IgoorCosta/codesDeficientesFisicos/TCC - Peças SolidWorks/Montagem protótipo.SLDASM

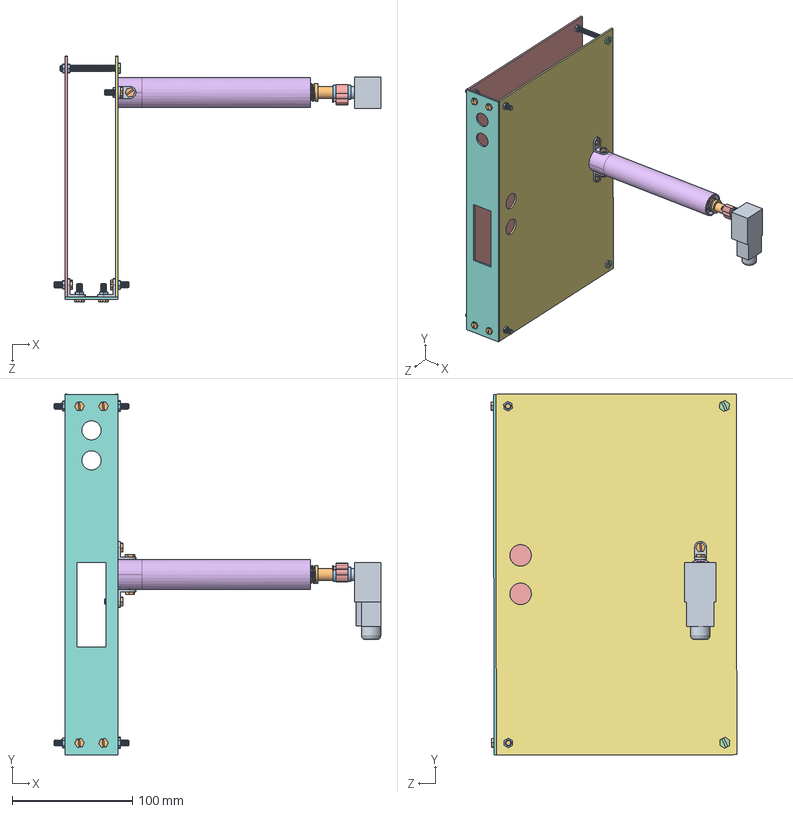
[picture p33: CAD file, 2024-02-06]
TCC - Peças SolidWorks/Montagem protótipo.SLDASM
271.6 x 300.2 x 204.3 mm
Motor
Rosca sem Fim
Mangueira
Porca grande x 4
Abraçadeira
PVC
Bancada inferior
Bancada da frente
Dobradiça x 6
Parafuso pequeno x 12
Porca pequena x 13
Parafuso Grande x 2
Bancada superior
