IgoorCosta/codesDeficientesFisicos/TCC - Peças SolidWorks/Montagem parte superior filme.SLDASM

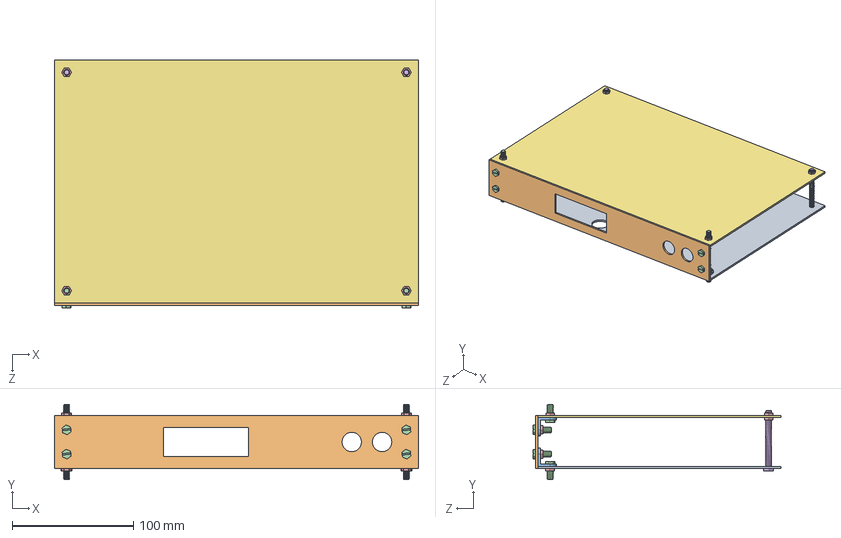
[picture p34: CAD file, 2024-02-06]
TCC - Peças SolidWorks/Montagem parte superior filme.SLDASM
300.0 x 62.0 x 204.0 mm
Bancada inferior
Bancada da frente
Dobradiça x 4
Parafuso pequeno x 8
Porca pequena x 12
Parafuso Grande x 2
Bancada superior
