IgoorCosta/codesDeficientesFisicos/TCC - Peças SolidWorks/Montagem parte inferior2.SLDASM

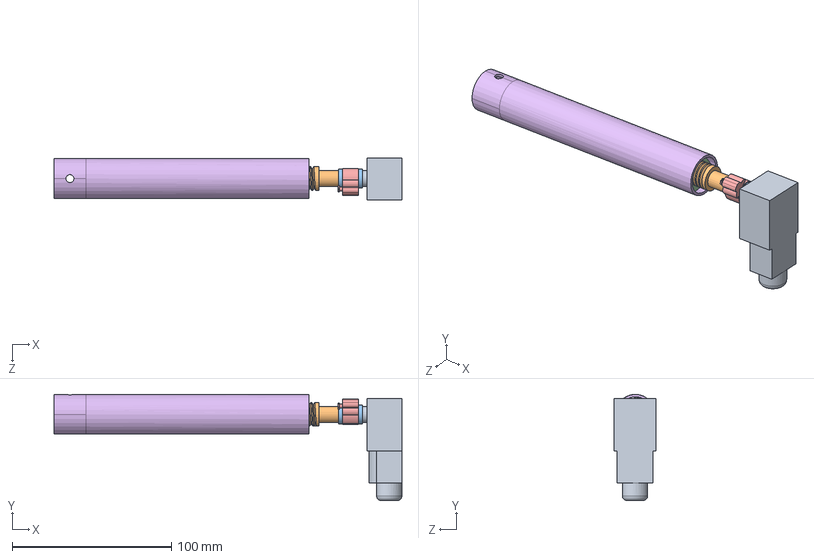
[picture p35: CAD file, 2024-02-06]
TCC - Peças SolidWorks/Montagem parte inferior2.SLDASM
218.6 x 66.7 x 26.5 mm
Motor
Rosca sem Fim
Mangueira
Porca grande x 4
Abraçadeira
PVC
