IgoorCosta/codesDeficientesFisicos/TCC - Peças SolidWorks/Montagem parte inferior.SLDASM

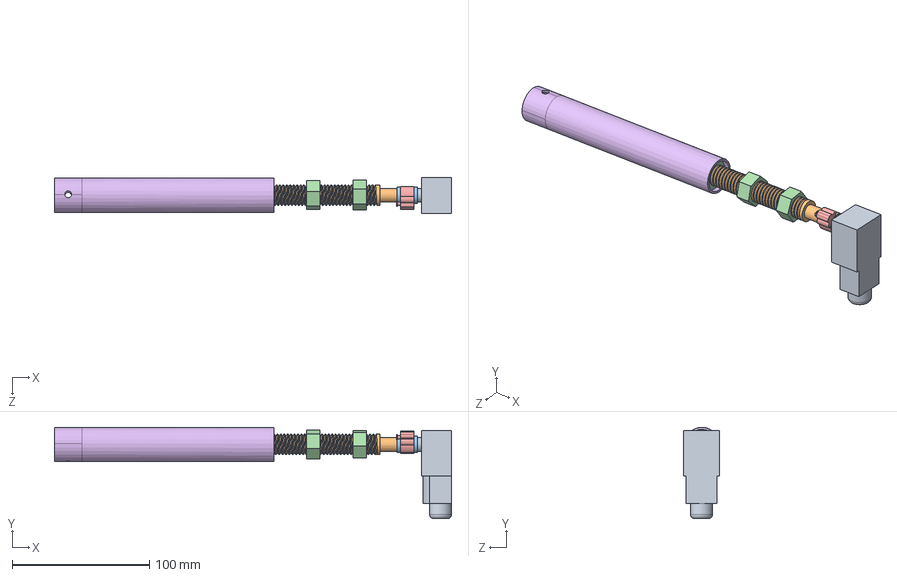
[picture p36: CAD file, 2024-02-06]
TCC - Peças SolidWorks/Montagem parte inferior.SLDASM
289.6 x 66.7 x 26.5 mm
Motor
Rosca sem Fim
Mangueira
Porca grande x 4
Abraçadeira
PVC
