IgoorCosta/codesDeficientesFisicos/TCC - Peças SolidWorks/Dobradiça.SLDPRT

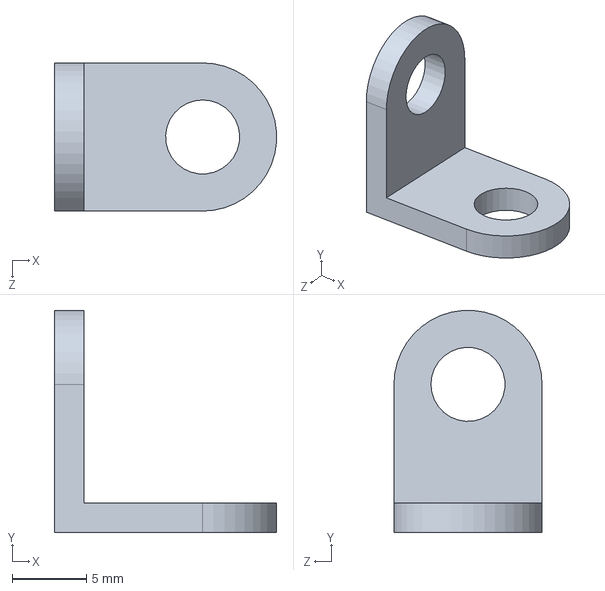
[picture p38: CAD file, 2024-02-06]
TCC - Peças SolidWorks/Dobradiça.SLDPRT
15.0 x 15.0 x 10.0 mm
