IgoorCosta/codesDeficientesFisicos/TCC - Peças SolidWorks/vermelho.SLDPRT

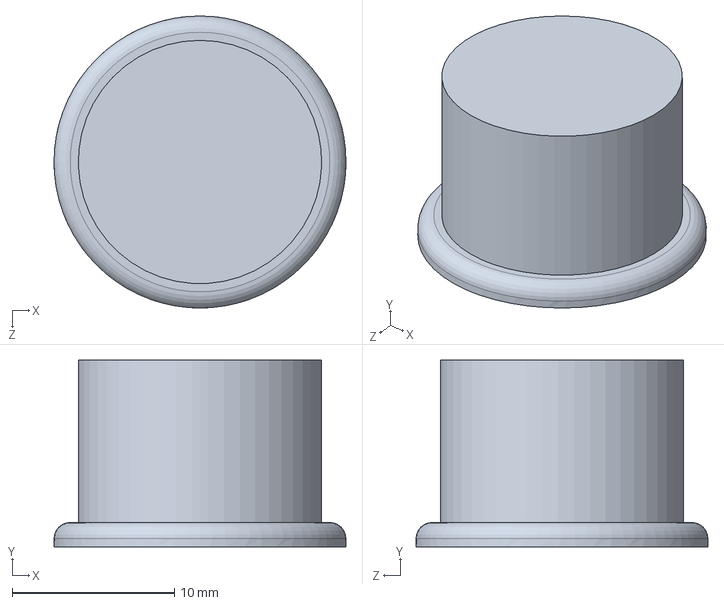
[picture p39: CAD file, 2024-02-06]
TCC - Peças SolidWorks/vermelho.SLDPRT
18.0 x 11.5 x 18.0 mm
