IgoorCosta/codesDeficientesFisicos/TCC - Peças SolidWorks/Abraçadeira.SLDPRT

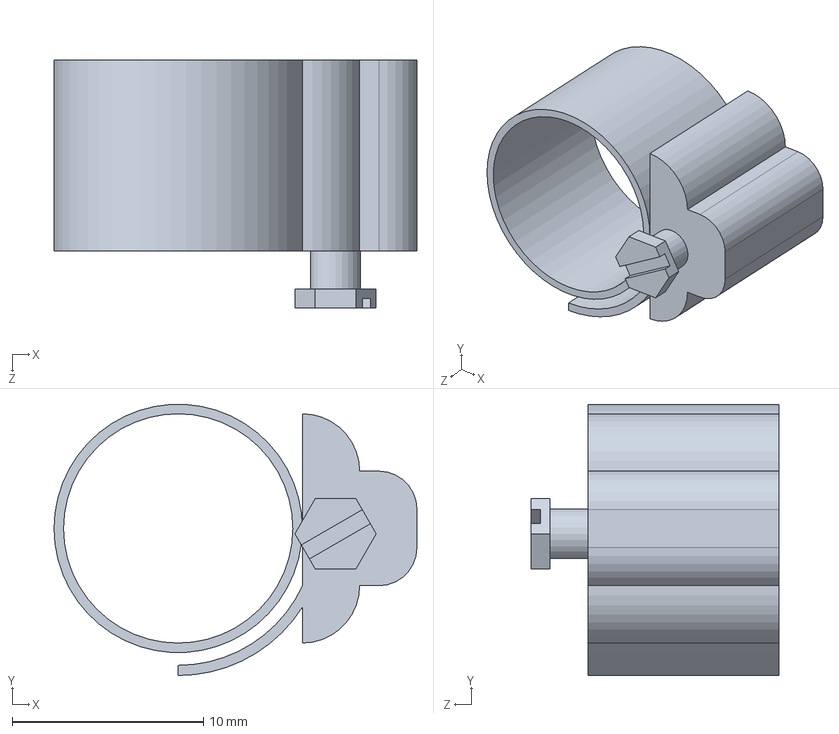
[picture p40: CAD file, 2024-02-06]
TCC - Peças SolidWorks/Abraçadeira.SLDPRT
19.0 x 14.2 x 13.0 mm
