IgoorCosta/codesDeficientesFisicos/TCC - Peças SolidWorks/Motor.SLDPRT

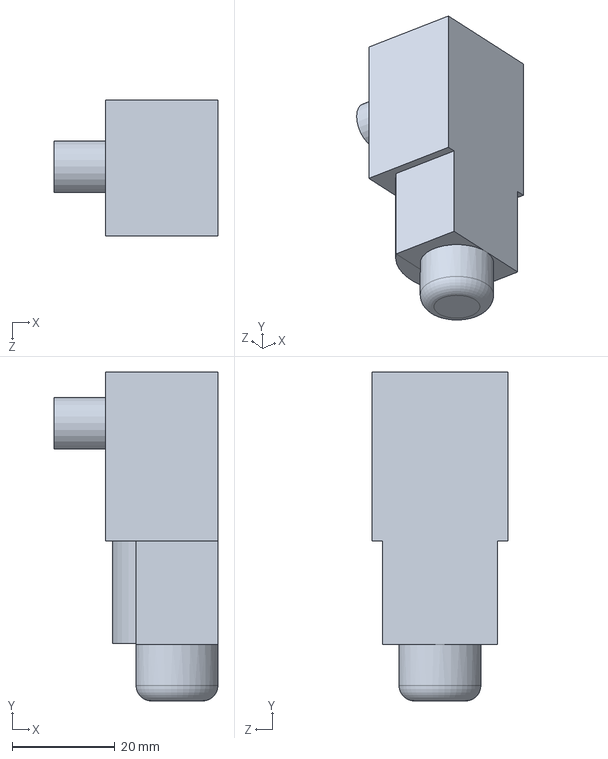
[picture p41: CAD file, 2024-02-06]
TCC - Peças SolidWorks/Motor.SLDPRT
32.0 x 64.2 x 26.5 mm
