IgoorCosta/codesDeficientesFisicos/TCC - Peças SolidWorks/Bancada inferior.SLDPRT

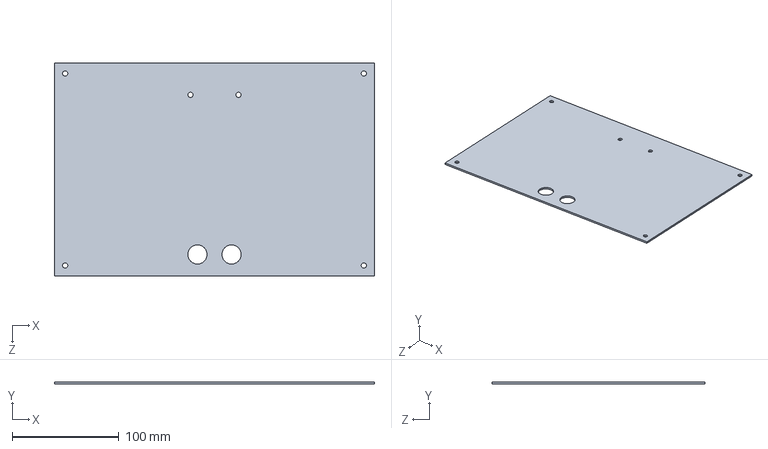
[picture p42: CAD file, 2024-02-06]
TCC - Peças SolidWorks/Bancada inferior.SLDPRT
300.0 x 2.00 x 200.0 mm
