IgoorCosta/codesDeficientesFisicos/TCC - Peças SolidWorks/LCD.SLDPRT

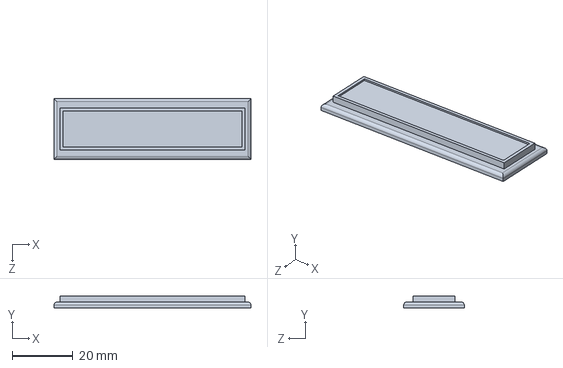
[picture p43: CAD file, 2024-02-06]
TCC - Peças SolidWorks/LCD.SLDPRT
65.0 x 4.00 x 20.0 mm
