IgoorCosta/codesDeficientesFisicos/TCC - Peças SolidWorks/Rosca sem Fim.SLDPRT

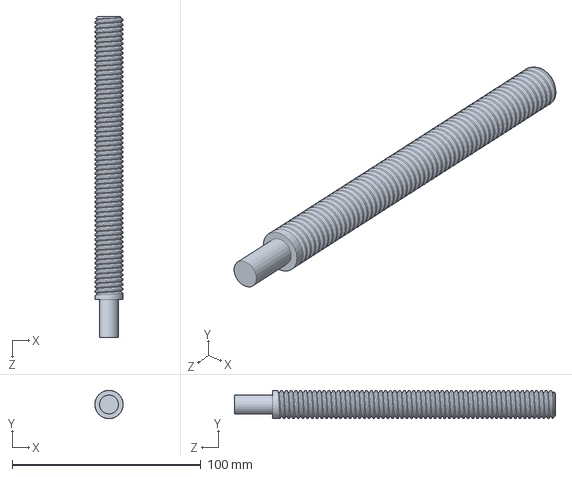
[picture p44: CAD file, 2024-02-06]
TCC - Peças SolidWorks/Rosca sem Fim.SLDPRT
15.0 x 15.0 x 170.0 mm
