IgoorCosta/codesDeficientesFisicos/TCC - Peças SolidWorks/Porca grande.SLDPRT

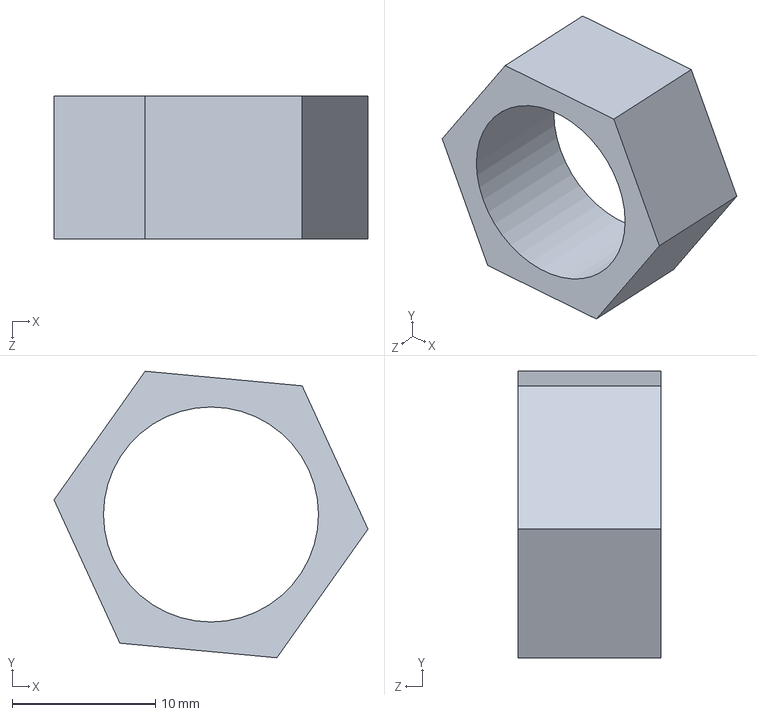
[picture p45: CAD file, 2024-02-06]
TCC - Peças SolidWorks/Porca grande.SLDPRT
21.9 x 20.0 x 10.0 mm
