IgoorCosta/codesDeficientesFisicos/TCC - Peças SolidWorks/Bancada da frente.SLDPRT

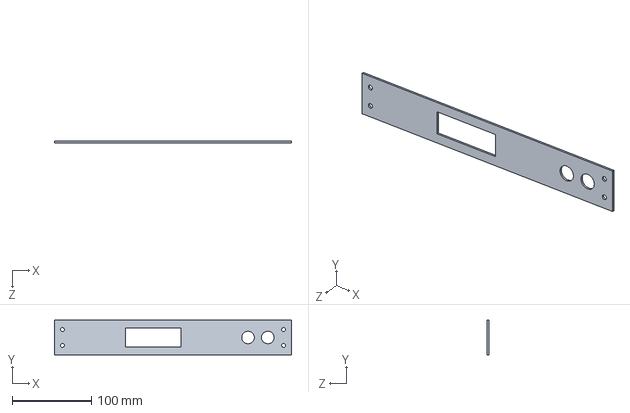
[picture p46: CAD file, 2024-02-06]
TCC - Peças SolidWorks/Bancada da frente.SLDPRT
300.0 x 44.0 x 2.00 mm
