IgoorCosta/codesDeficientesFisicos/TCC - Peças SolidWorks/Mangueira.SLDPRT

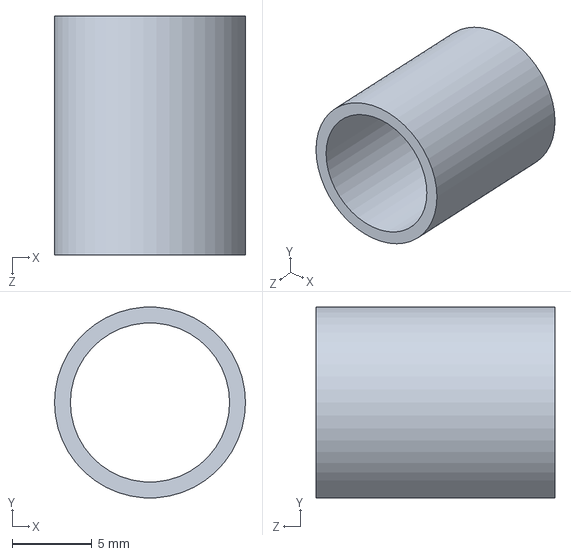
[picture p47: CAD file, 2024-02-06]
TCC - Peças SolidWorks/Mangueira.SLDPRT
12.0 x 12.0 x 15.0 mm
