IgoorCosta/codesDeficientesFisicos/TCC - Peças SolidWorks/PVC.SLDPRT

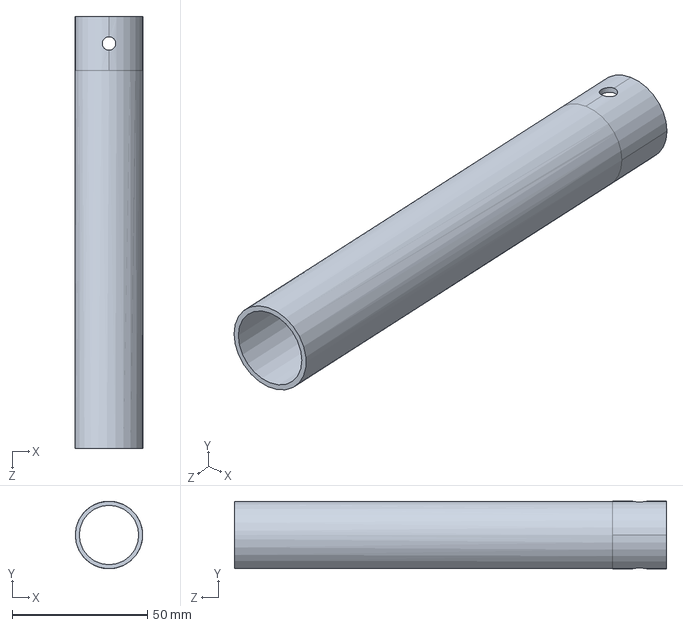
[picture p48: CAD file, 2024-02-06]
TCC - Peças SolidWorks/PVC.SLDPRT
25.0 x 25.0 x 160.0 mm
