IgoorCosta/codesDeficientesFisicos/TCC - Peças SolidWorks/Parafuso Grande.SLDPRT

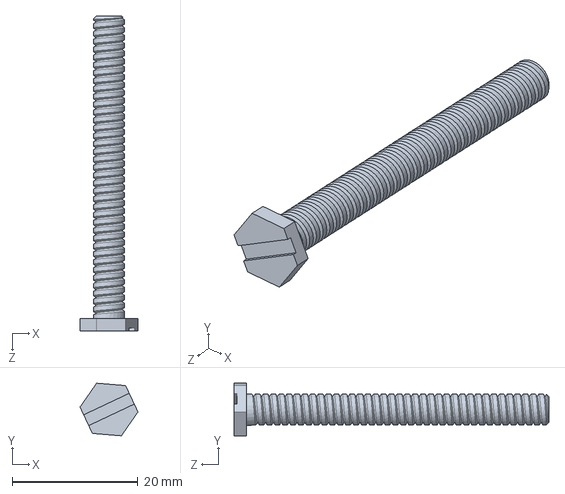
[picture p49: CAD file, 2024-02-06]
TCC - Peças SolidWorks/Parafuso Grande.SLDPRT
9.21 x 8.35 x 50.0 mm
