IgoorCosta/codesDeficientesFisicos/(list of files, cad)

Other CAD files:
TCC - Peças SolidWorks/Montagem parte superior.SLDASM
TCC - Peças SolidWorks/botao verde.SLDPRT
TCC - Peças SolidWorks/Bancada superior.SLDPRT
